leonardovazquez/IHP__QDLL6501/release/v.1.0.0/doc/UNIC-CASS_QDLL_Mock Tape Out.pdf

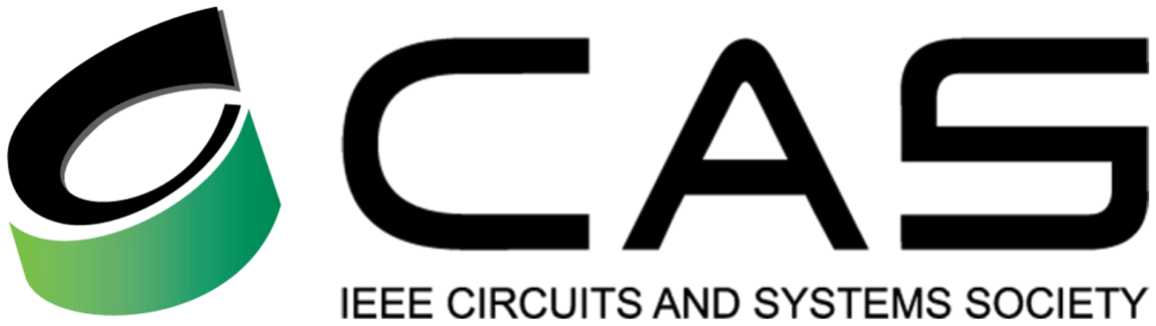
[picture p1: figure]

# UNIC-CASS

# Mock Tapeout “250 MHz Quadrature Delay Locked Loop ”

27.01.2026

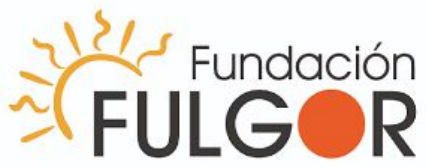
[picture p2: figure]
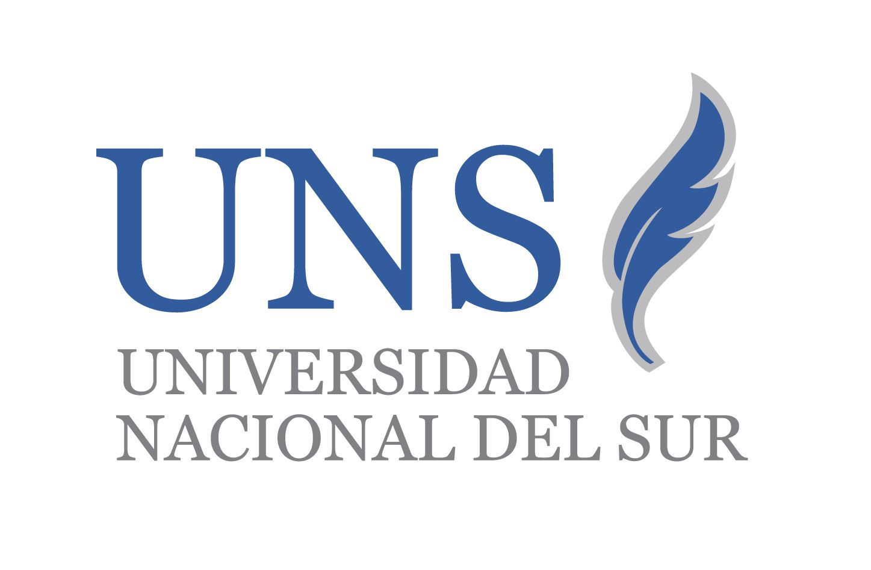
[picture p3: figure]
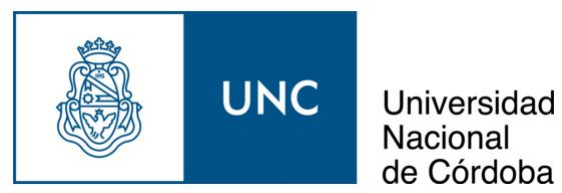
[picture p4: figure]

# Content

## 1. Fundamentals

## 2. QDLL Project: Block Diagram and Specifications

## 3. Schematics: TOP and Sub-blocks: Symbols & Schematics & Layouts

## 4. Characterization Testbenches

5. TOP Simulation: Testbench with the IO-Cells. Characterization Testbenches.
6. QDLL Layout: Top Layout and layout within the pad ring.
7. QDLL: Pins and IO Cells.

## 8. Project Status

# 1- QDLL Fundamentals

# 1 - QDLL Fundamentals

The Quadrature Delay Locked Loop (QDLL) is a phase control system designed to delay a differential CMOS input signal by 90°, generating a differential quadrature-phase output.

The QDLL operates through three key components:

1. Phase Detector (PD) + Charge Pump (CP):: Measures the phase difference between the input signal ϕin and the delayed output ϕout , and generates a proportional
voltage | Vcont.
2. Large Voltage-Controlled Delay Line (Large VCDL): Introduces a controllable delay to the input signal,
adjusted | by | the | control | voltage | Vcont.
3. Feedback Loop: Processes the phase error signal from the phase detector and adapts the VCDL delay until the
phase | difference | is | locked | at | 90°.

The main goal of the QDLL is to achieve and maintain a quadrature (90°) phase shift between the input and output signals.

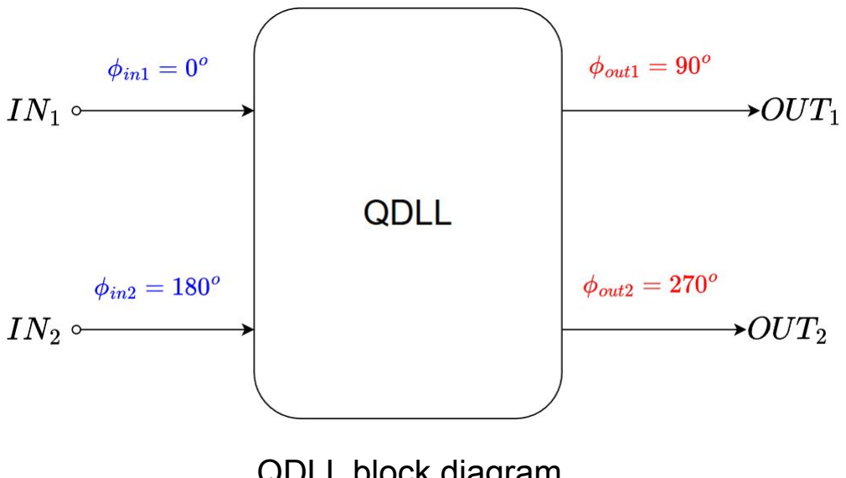
[picture p5: figure]

QDLL block diagram

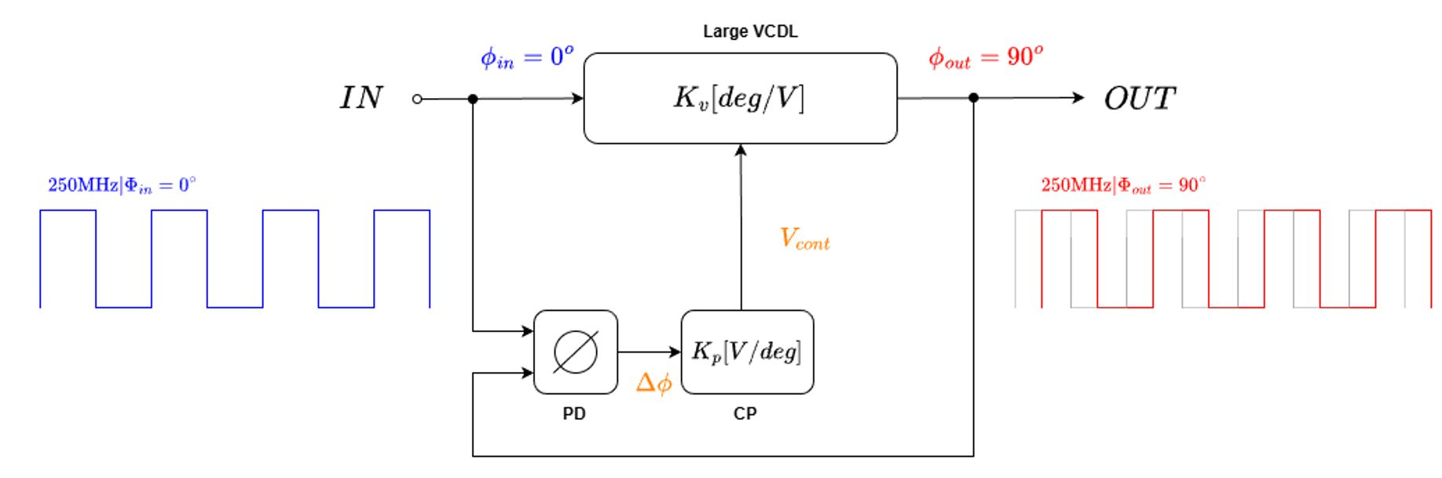
[picture p6: figure]

Single QDLL Operation

# 1 - QDLL Fundamentals

If we model the diagram of the single QDLL operation, we observe the phase detector compares the input and output phases (ϕin & ϕout), and any phase error is converted into a control voltage via the charge pump or loop filter. This voltage, Vcont , tunes the delay element (Large VCDL) with gain KvKp, adjusting the phase of the output signal ϕout.

On the other hand, using a single pole (1/S) in the feedback path guarantees inherent stability and ensures smooth convergence. Therefore, a simple RC network can be an effective choice for implementation.

This feedback mechanism ensures that the system locks the output phase at a fixed offset (e.g., 90° for QDLL) from the input phase eliminating steady-state phase error.

The Phase Converge plot shows that:

- A stable locking point exists where the two characteristics intersect. ( 90° is the desired )
- The negative slope of the VCDL ensures that the loop has a stable operating point.

QDLL System Operation

Phase Convergence

# 2- QDLL Project Diagram & Specifications

# 2 - QDLL Project Diagram

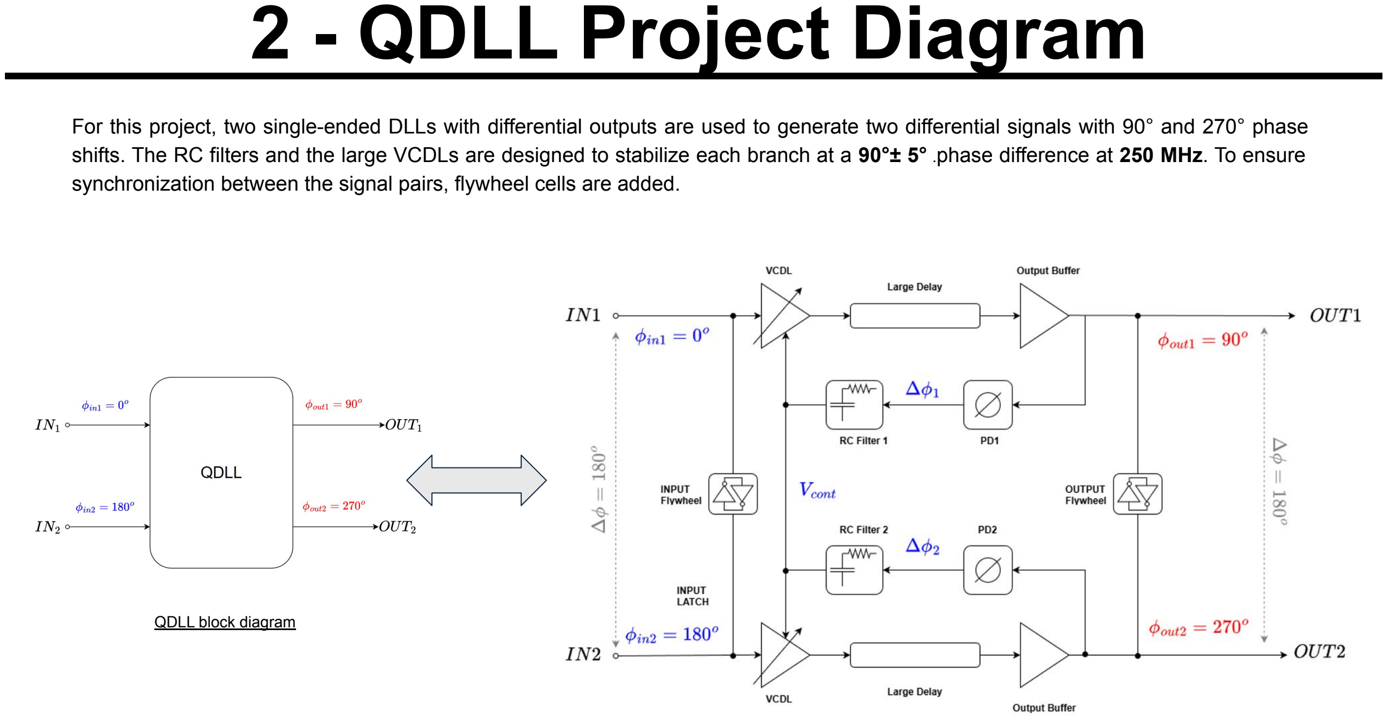
[picture p7: page 7]

For this project, two single-ended DLLs with differential outputs are used to generate two differential signals with 90° and 270° phase shifts. The RC filters and the large VCDLs are designed to stabilize each branch at a 90°± 5° .phase difference at 250 MHz. To ensure synchronization between the signal pairs, flywheel cells are added.

QDLL block diagram

# 2 - QDLL Project Specifications

The design specifications were modified due to the high-frequency behavior of the I/O cells. As a result, the performance requirements were relaxed, along with adjustments to the project focus and the number of input/output pins.

ihp 130 nm

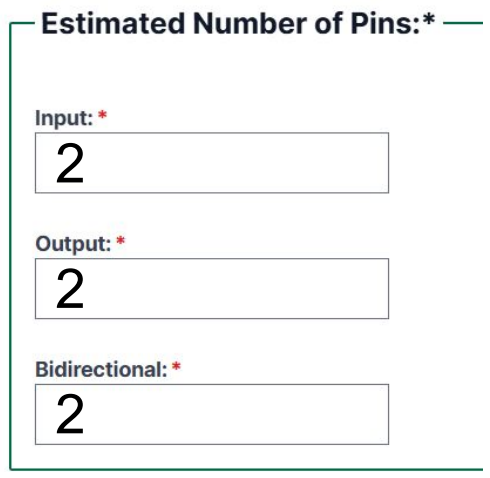
[picture p8: figure]

Pins:

- 2 Bi-direcctional: VDD, VSS
- 2 inputs: inpad1, inpad2
- 2 outputs: outpad1, outpad2

QDLL Specifications

Boundary Conditions | Requirement
Techn. | CMOS
Node | 130 nm
Supply Voltage | 1.2 ± 5% V
Temperature | [0, 65, 125] °C
Input Amplitude | [0 , 1.2 ] V (CMOS)
Input Frequency | 250±25 MHz
Input/Output Type | Fully Differential
Specifications | Value
Phase Difference | 90 ± 5 degrees
Output Swing | [0 , 1.2 ] V (CMOS)
t_rise/t_fall output | <
Vcont_ripple | ≥ 9 bits
Output Jitter | ≥ 7.5 bits

# 3- QDLL Project Schematics & Layouts

# 3 - QDLL Schematics (TOP)

# - Differential QDLL TOP:

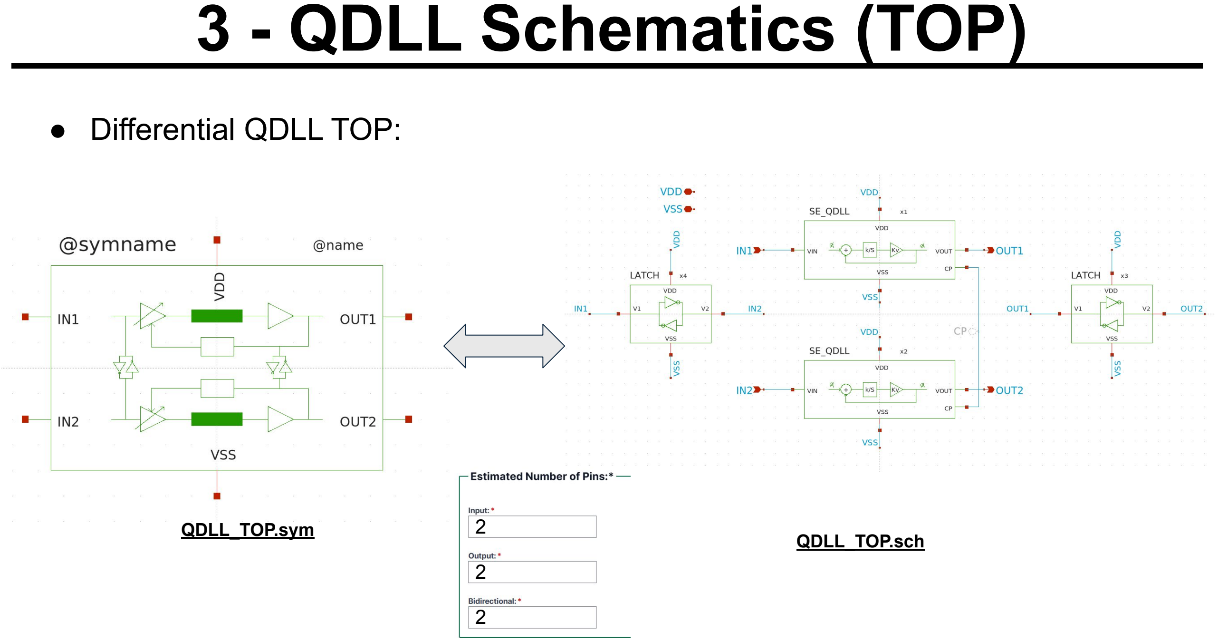
[picture p9: page 10]

2

2

2

QDLL_TOP.sym | QDLL_TOP.sch

# 3 - QDLL Schematics

# - Single-Ended QDLL:

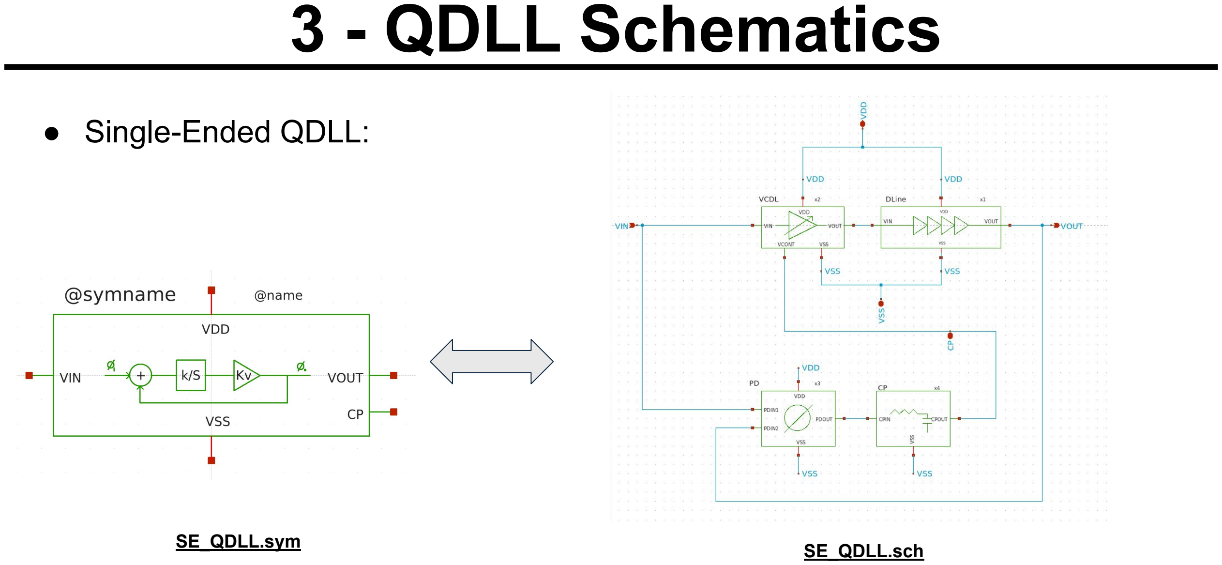
[picture p10: page 11]

SE_QDLL.sym | SE_QDLL.sch

# 3 - QDLL Schematics & Layouts

# - Voltage-Controlled Delay Line (VCDL) :

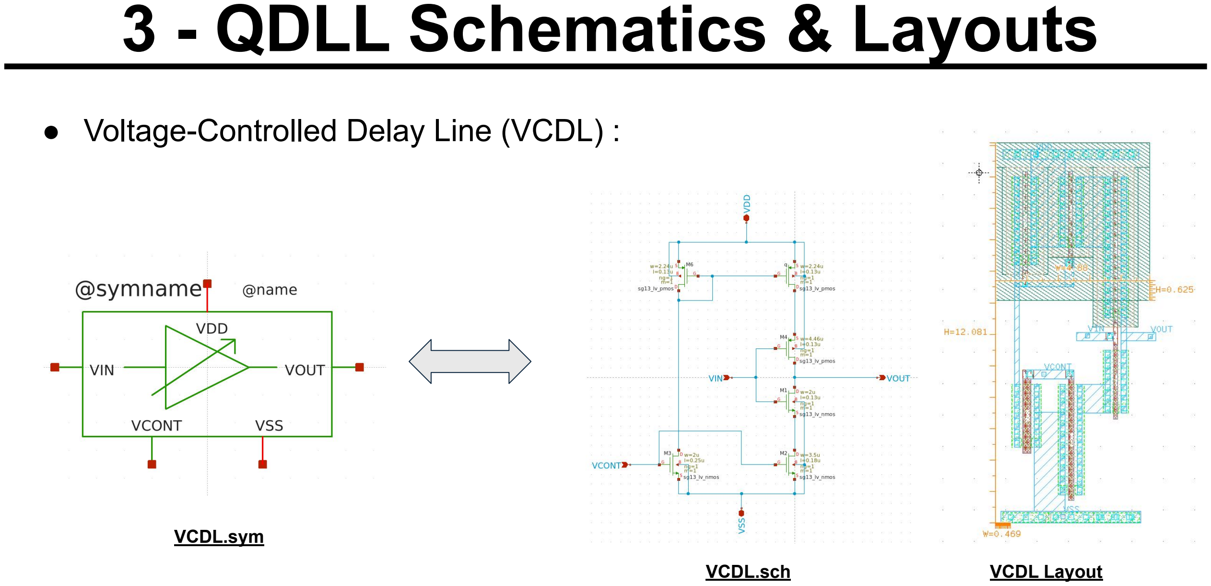
[picture p11: page 12]

VCDL.sym

VCDL.sch | VCDL Layout

# 3 - QDLL Schematics & Layouts

# - Large delay Line + Buffer Stage (DLine) :

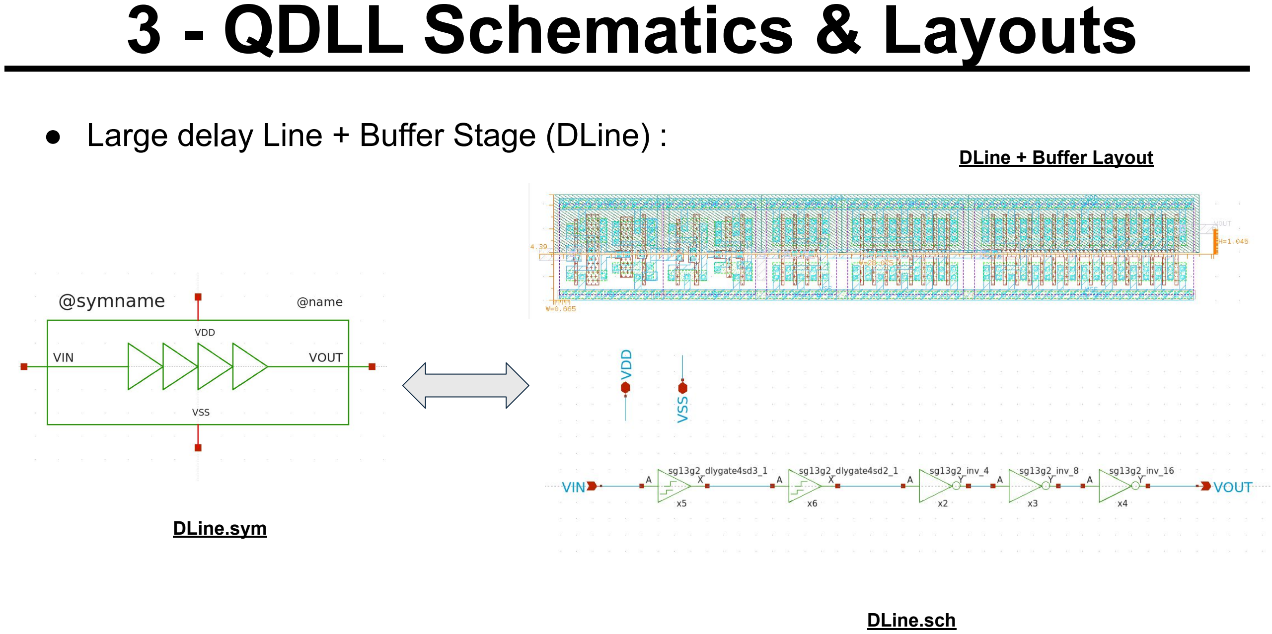
[picture p12: page 13]

DLine.sym

DLine.sch

DLine + Buffer Layout

# 3 - QDLL Schematics & Layouts

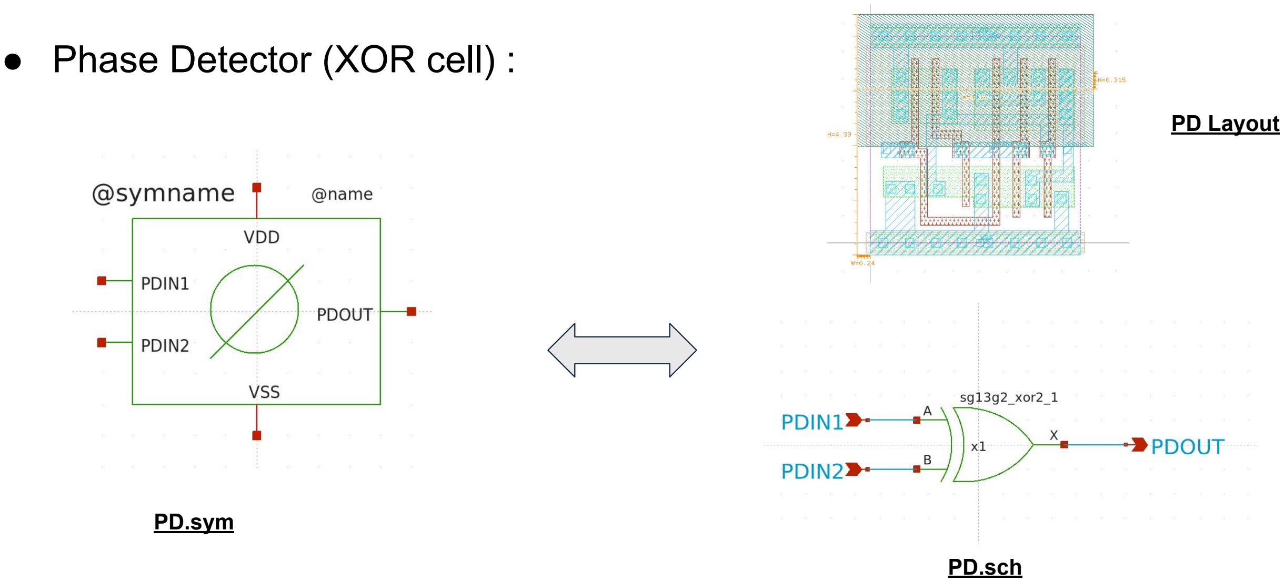
[picture p13: figure]
● Phase Detector (XOR cell) :; PD.sym; PD.sch; PD Layout

# 3 - QDLL Schematics & Layouts

# - Charge-Pump/ RC Loop Filter:

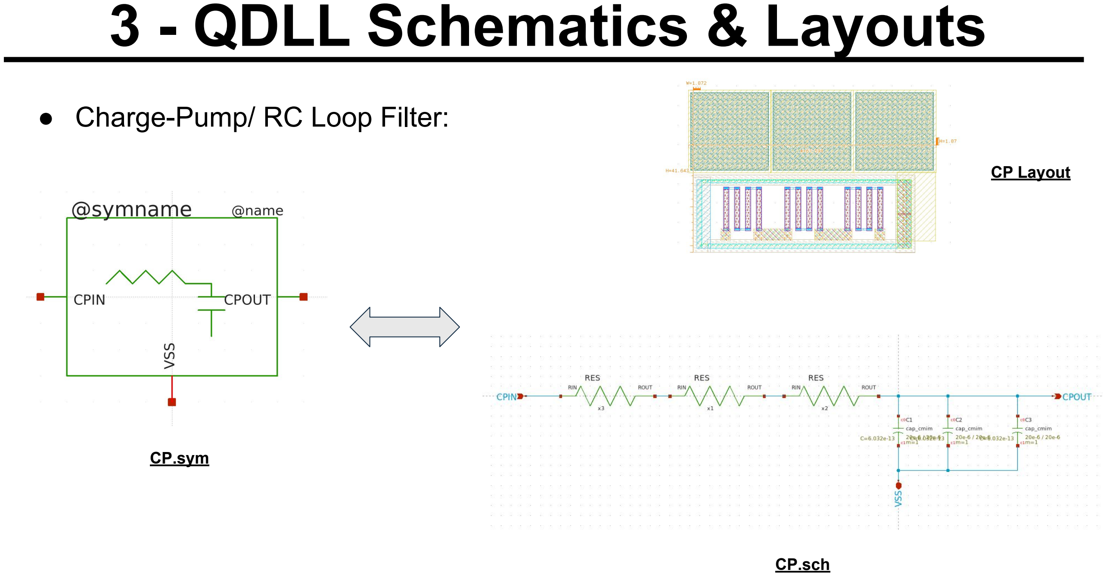
[picture p14: page 15]

CP.sym

CP.sch

CP Layout

# 3 - QDLL Schematics & Layouts

# - Series Resistors:

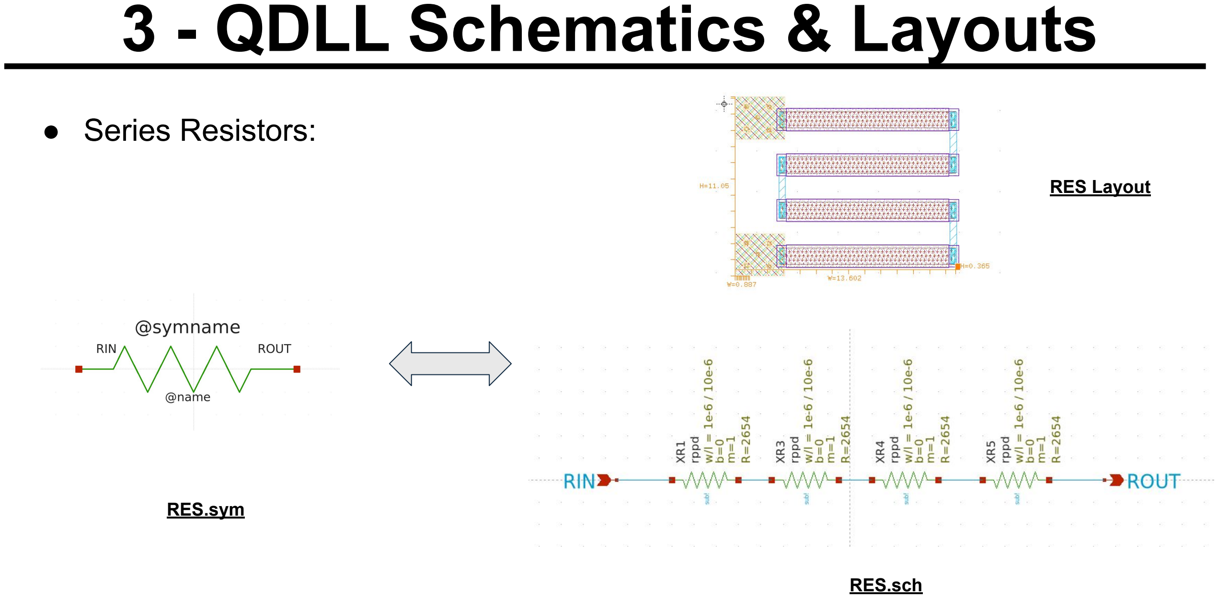
[picture p15: page 16]

RES.sym

RES.sch

RES Layout

# 3 - QDLL Schematics

# - Flywheel Latchs:

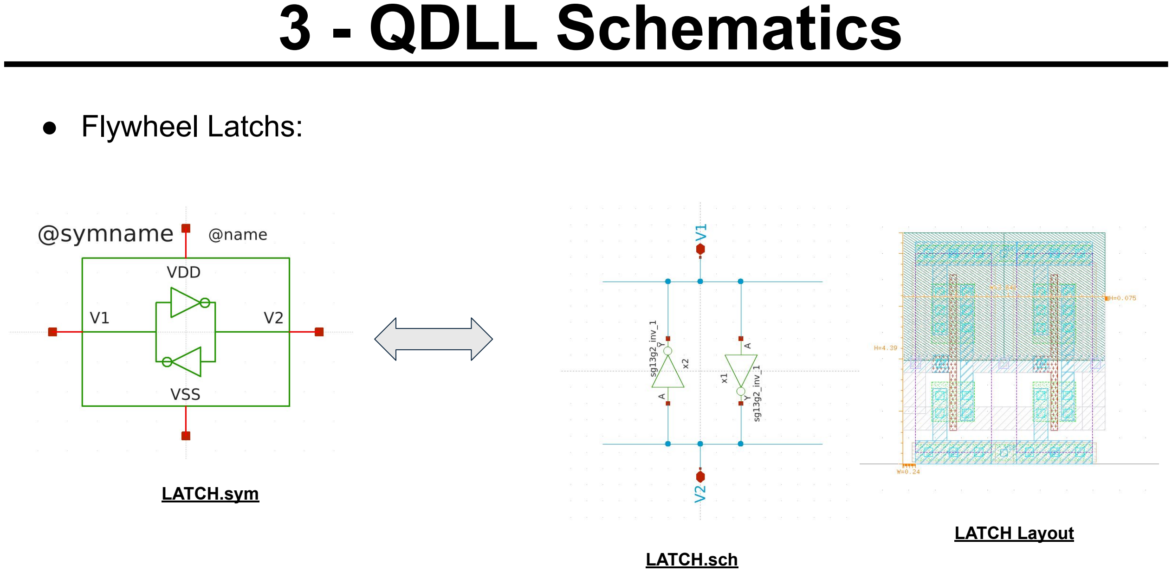
[picture p16: page 17]

LATCH.sym

LATCH.sch

LATCH Layout

# 4- QDLL Characterization Testbenchs

# 4 - QDLL Testbenchs

# - PD + CP Characterization Testbench

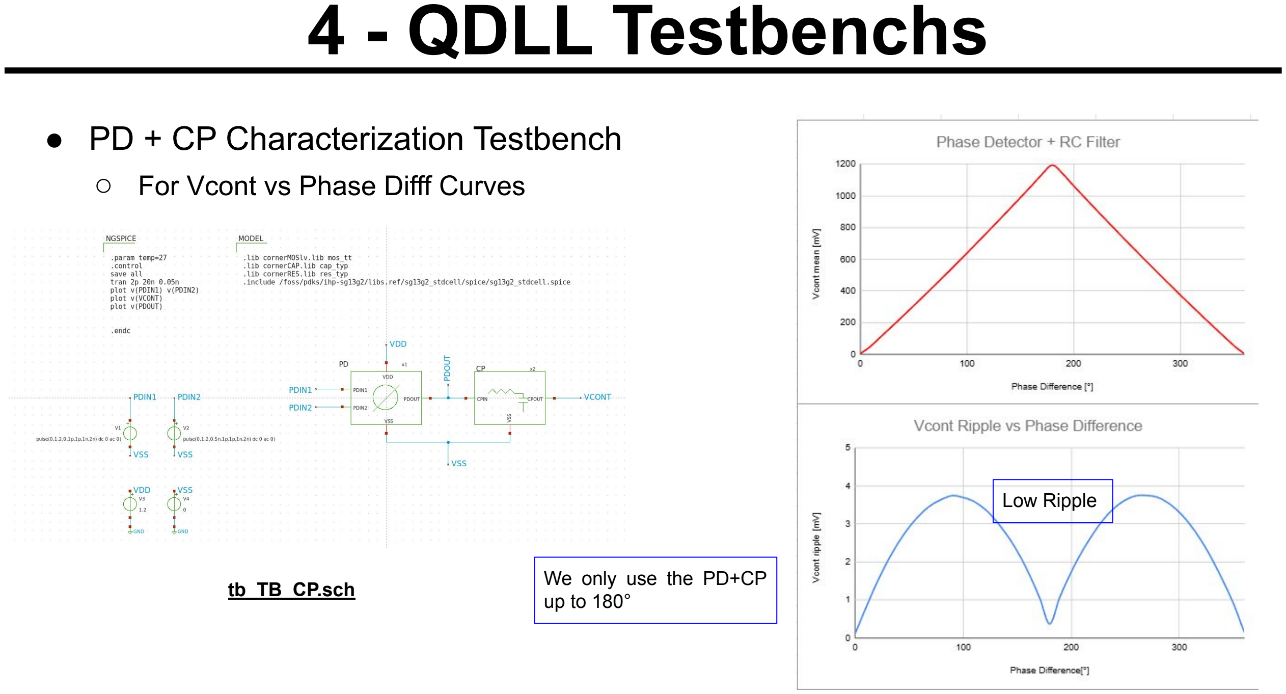
[picture p17: page 19]

## - For Vcont vs Phase Difff Curves

tb_TB_CP.sch

Low Ripple

We only use the PD+CP
up to 180°

# 4 - QDLL Testbenchs

# - IO CELLS Characterization Testbench

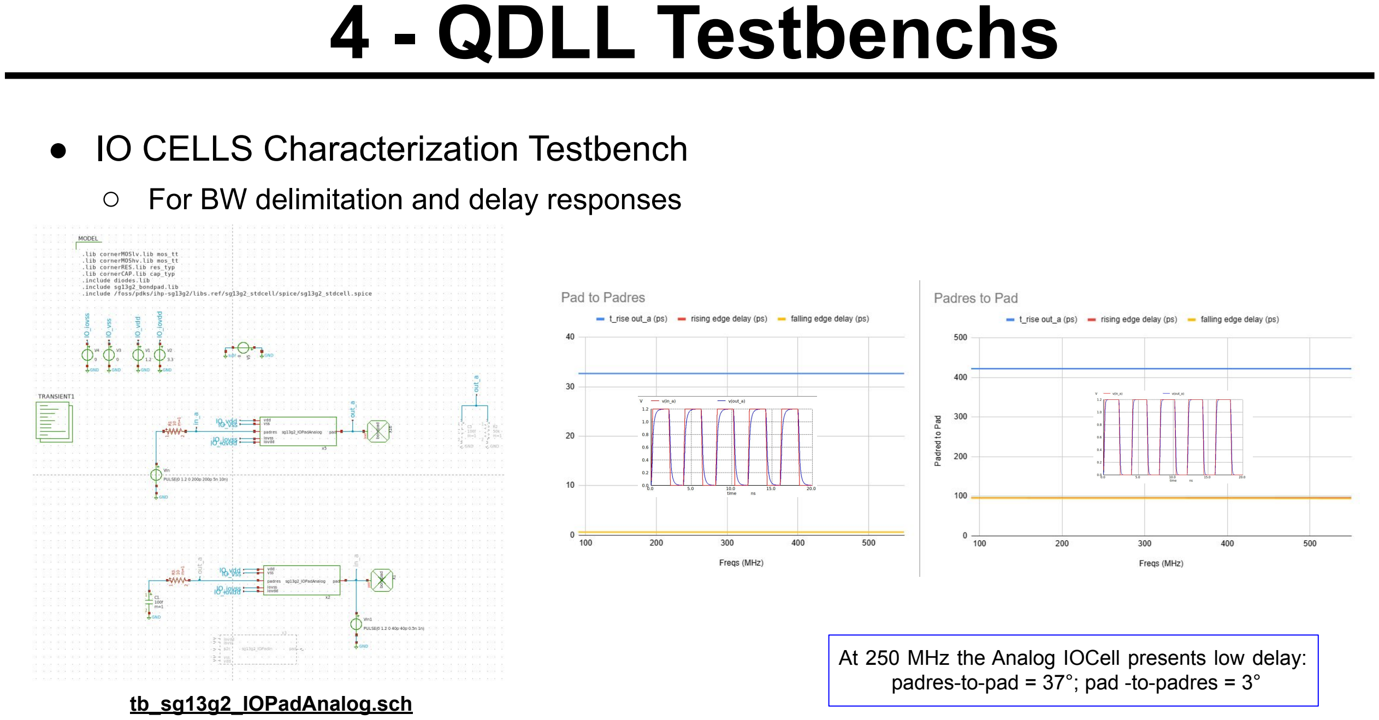
[picture p18: page 20]

## - For BW delimitation and delay responses

tb_sg13g2_IOPadAnalog.sch

At 250 MHz the Analog IOCell presents low delay: padres-to-pad = 37°; pad -to-padres = 3°

# 4 - QDLL Testbenchs

# - Open Loop for Large Delay Line Characterization Testbench

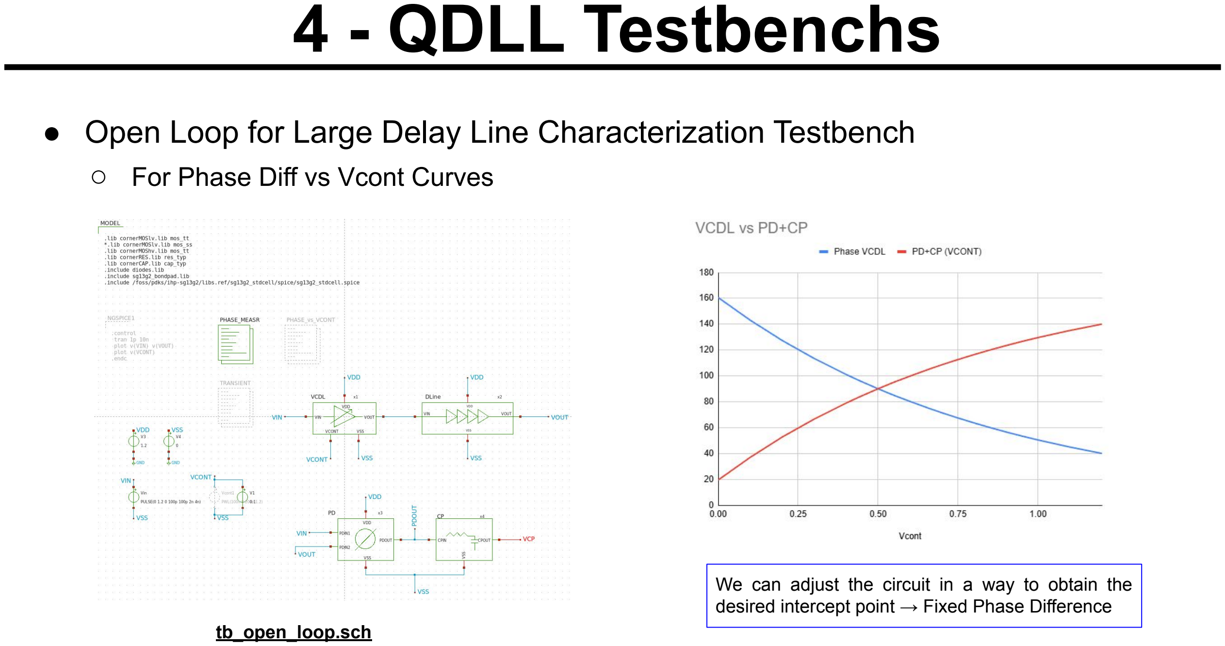
[picture p19: page 21]

## - For Phase Diff vs Vcont Curves

tb_open_loop.sch

We can adjust the circuit in a way to obtain the desired intercept point → Fixed Phase Difference

# 5- QDLL TOP Testbench

# 5 - QDLL TOP Testbench (TT)

# - TOP Testbench with the IOCELLS

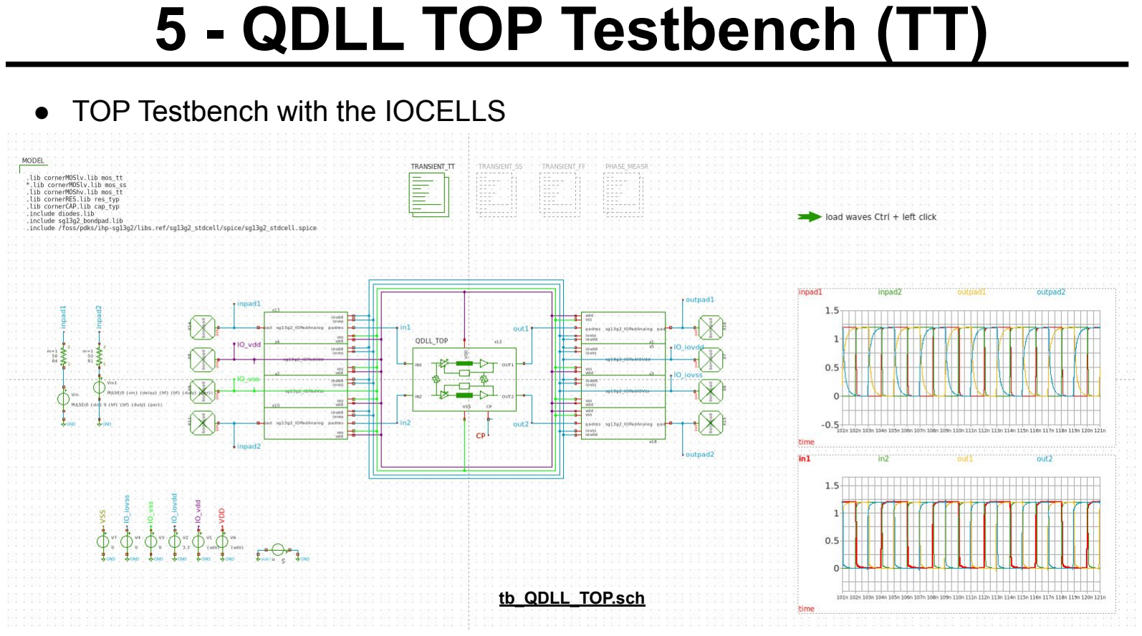
[picture p20: page 23]

tb_QDLL_TOP.sch

# 5 - QDLL TOP Testbench (TT)

# - Setup Time

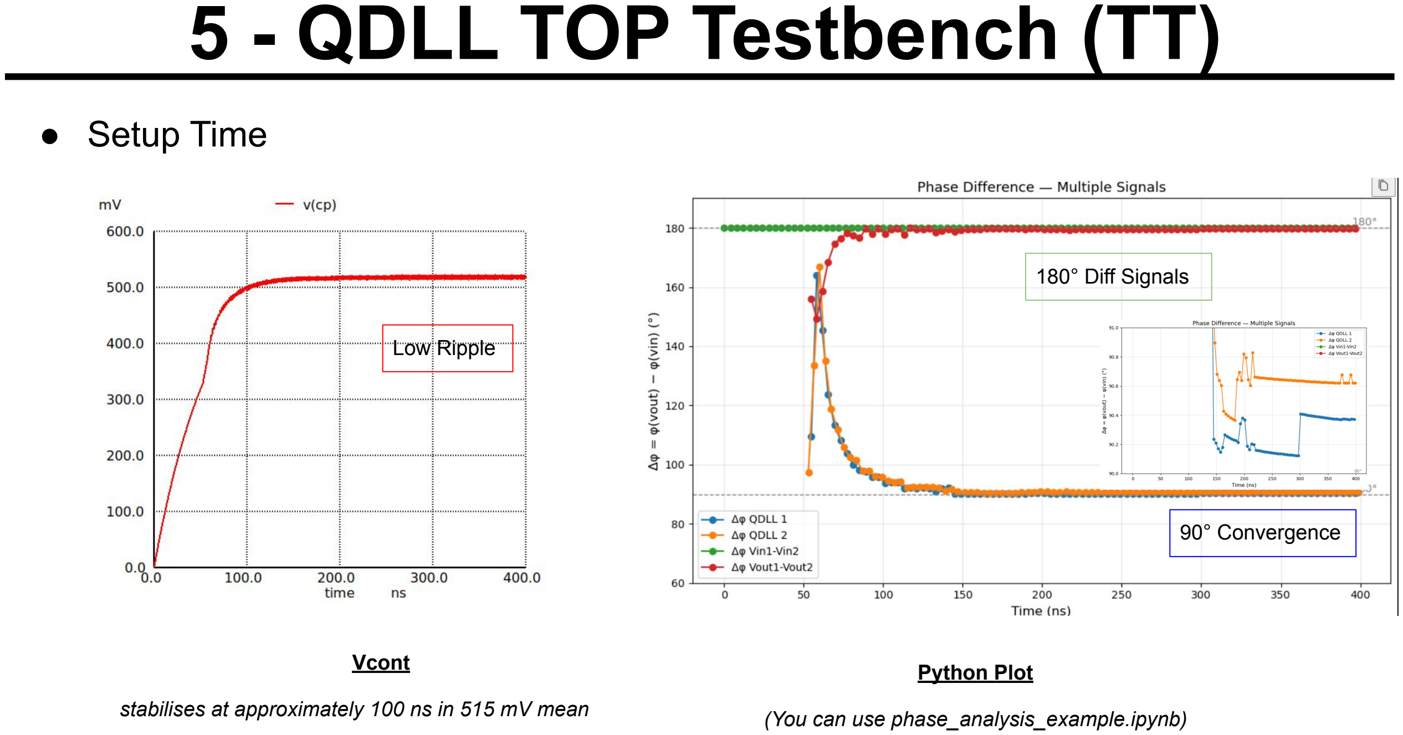
[picture p21: page 24]

Python Plot

(You can use phase_analysis_example.ipynb)

90° Convergence

180° Diff Signals

Vcont

stabilises at approximately 100 ns in 515 mV mean

Low Ripple

# 5 - QDLL TOP Testbench (TT)

# - Input/Output Signals

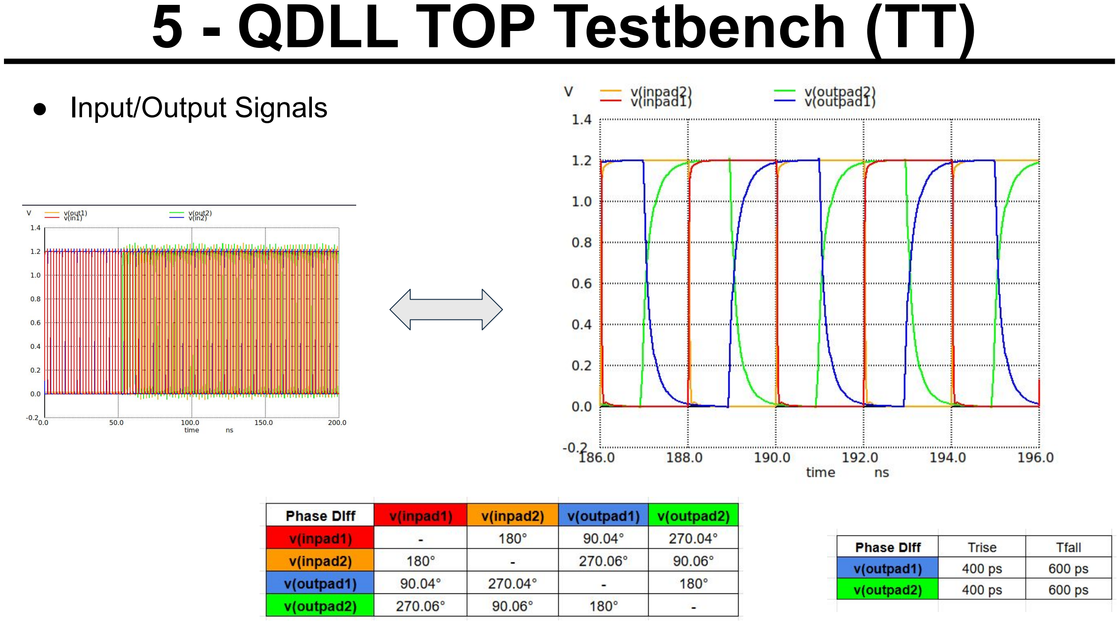
[picture p22: page 25]

# 5- QDLL Layout TOP

# QDLL Top Layout Placement

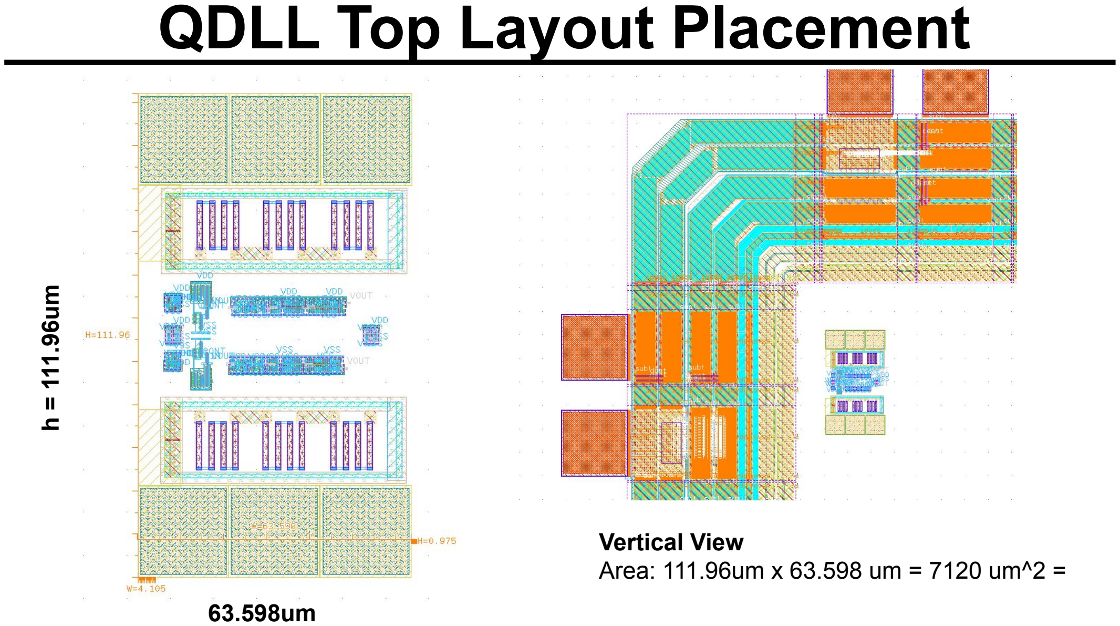
[picture p23: page 27]

## h = 111.96um

63.598um

## Vertical View Area: 111.96um x 63.598 um = 7120 um^2 =

# QDLL Top Layout Placement v1

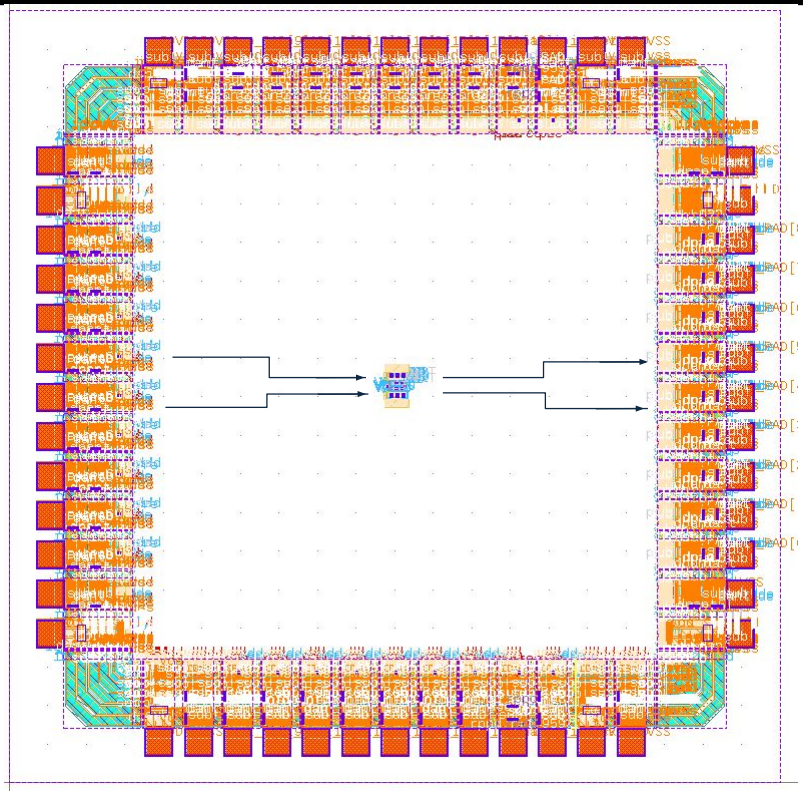
[picture p24: figure]

## One possible goal would be to place the QDLL vertically and connect the inputs on the left and the outputs on the right with high metal top

routing.

For | a | 250 MHz | signal,

## standard IO cells have been tested and found to perform

well. However, if available,

## we prefer to interface with 50 Ω systems using IO cells

with matched impedance.

# QDLL layout within the pad ring

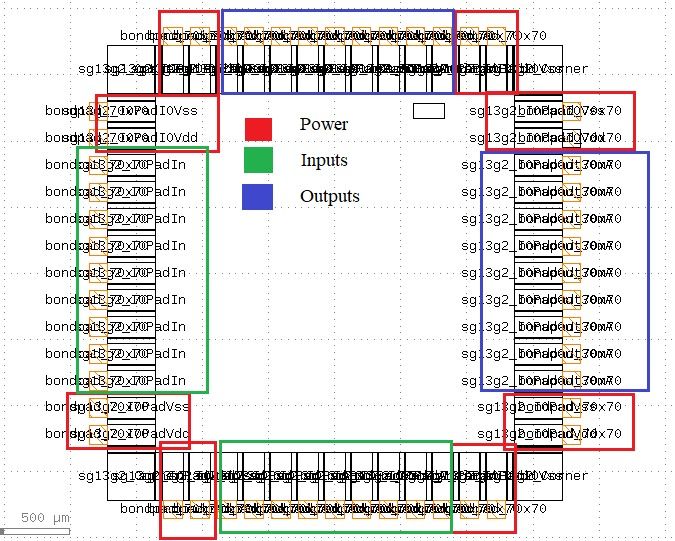
[picture p25: figure]

# 7 - QDLL Pins and IO CELLS

# Pins and IO Cells

## QDLL Pins

## N° Pins: 4 - 2 Input Pins - 2 Output Pin - 2 Power Supply Pins (VDD , VSS)

Pin Type | Name | IOCELL
Input | inpad1 | sg13g2_IOPADAnalog
Input | inpad2 | sg13g2_IOPADAnalog
Output | outpad1 | sg13g2_IOPADAnalog
Output | outpad1 | sg13g2_IOPADAnalog

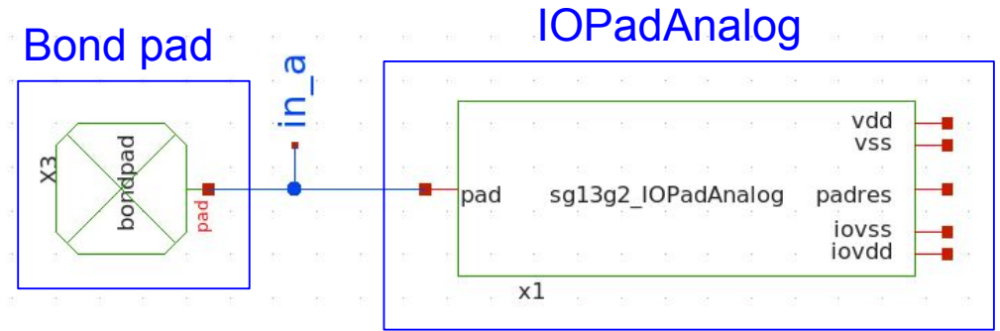
[picture p26: figure]
Bond pad; IOPadAnalog

Power Supply | VDD | sg13g2_IOPadVdd
Power Supply | VSS | sg13g2_IOPadVss

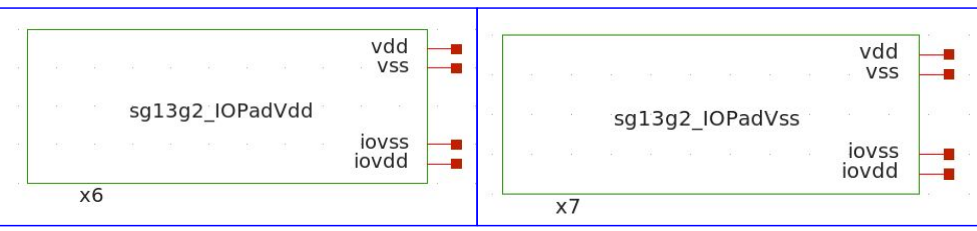
[picture p27: figure]

## Power Supply IOPads

# 8- QDLL Project Status

33

# Project Status

TOP | Sub-top | Sub-Block | Symbols & Schematic s | Testbench | Prelayout results | IOCELLS results (TT) | IOCELLS results (SS-FF) | Layout (DRC + LVS) | Postlayout results
QDLL TOP | - | - | Done | Done | Done | Done | To do | WIP | To do
- | SE_QDLL | - | Done | Done | Done | Done | To do | WIP | To do
- | - | VCDL | Done | Done | Done | Done | W/P | WIP | To do
- | - | DLine | Done | Done | Done | Done | WIP | Done | To do
- | - | CP | Done | Done | Done | Done | WIP | WIP | To do
- | - | PD | Done | Done | Done | Done | WIP | Done | To do
- | LATCH | - | Done | Done | Done | Done | WIP | Done | To do

## Project Status by Block:

## We are currently working on

the | DRC | (minimum | and
maximum) | verification | of

## several cells to achieve the

desired | LVS | verification.

## Next, we plan to compare the extracted views using Magic in order to obtain more

realistic results.

On | the | other | hand,
multi-corner | simulation

## results are desirable for our project, and we are actively

working toward that goal.
