leonardovazquez/IHP__QDLL6501/release/v.1.0.0/doc/DLL_top_full.png

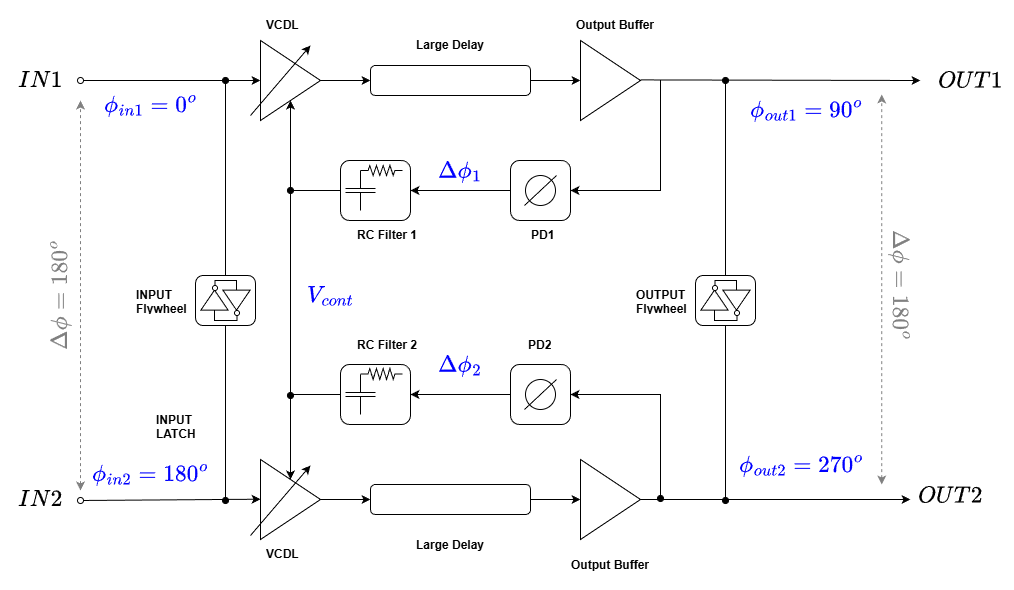
release/v.1.0.0/doc/DLL_top_full.png
