leonardovazquez/IHP__QDLL6501/release/v.1.0.0/doc/QDLL_Diagram.png

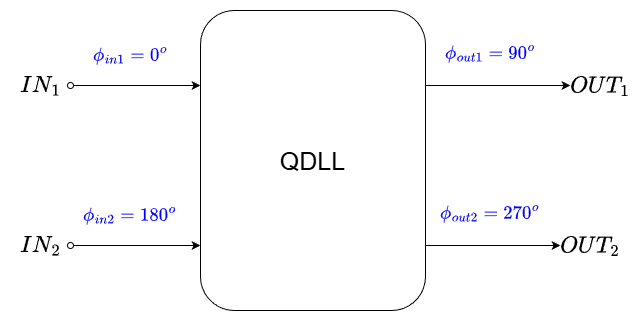
release/v.1.0.0/doc/QDLL_Diagram.png
