leonardovazquez/IHP__QDLL6501/release/v.1.0.0/doc/QDLL - VAZQUEZ - 2nd UNIC-CASS Progress Questionnaire.pdf

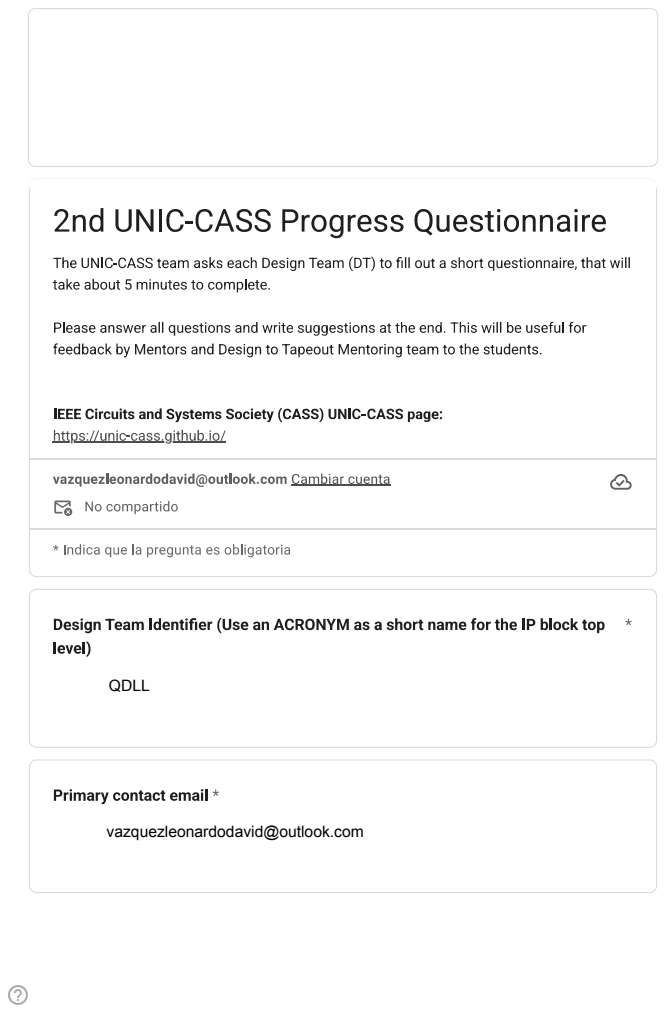
[picture p30: page 1]
QDLL

vazquezleonardodavid@outlook.com

## leonardo.vazquez@ieee.org

## Santiago Basignana

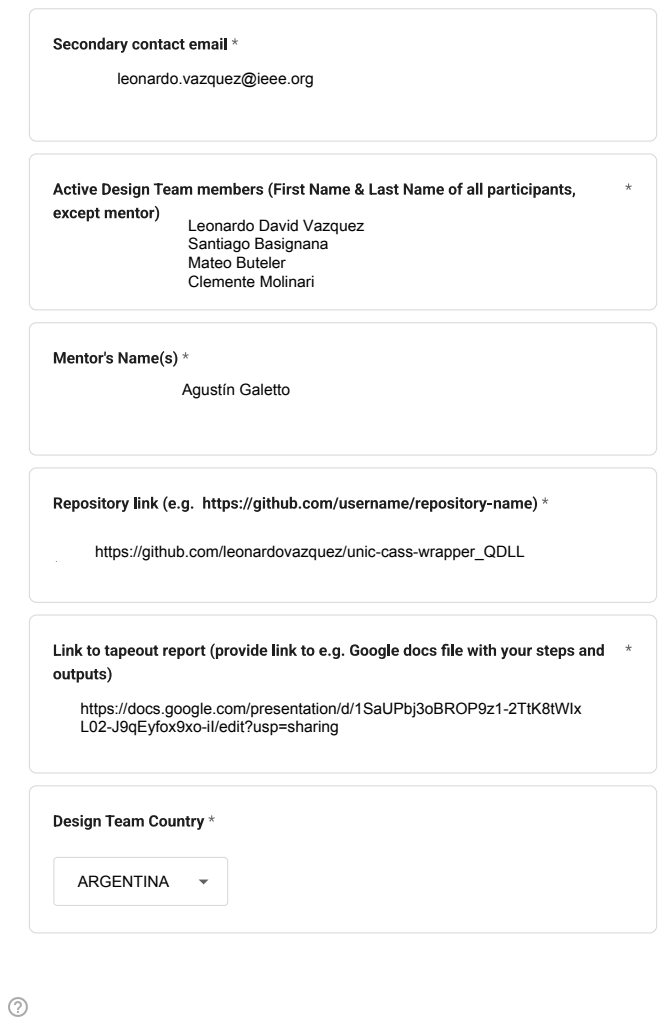
[picture p31: page 2]
Agustín Galetto; ARGENTINA

Leonardo David Vazquez
Mateo Buteler
Clemente Molinari

https://github.com/leonardovazquez/unic-cass-wrapper_QDLL

https://docs.google.com/presentation/d/1SaUPbj3oBROP9z1-2TtK8tWIx
L02-J9qEyfox9xo-iI/edit?usp=sharing

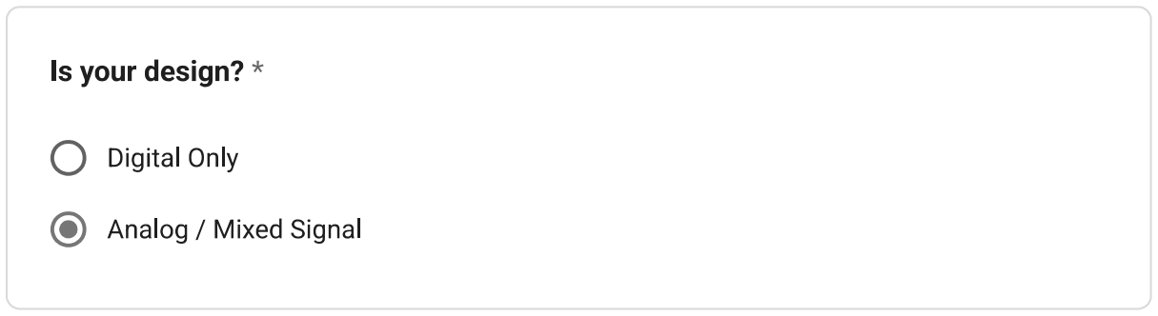
[picture p32: figure]

## sg13g2_IOPADAnalog that we mentioned in our document. Also, we can migrate

## models. If this is not possible, as we have demonstrated, we will use the IO Cells

## using IO cells with matched impedance. We would need the new RF iocells

## perform well. However, if available, we prefer to interface with RF 50•Ω systems

## V) 250•MHz input signal, standard IO cells have been tested and found to

## signal (2 inputs) and 1 differential output signal (2 outputs). For a CMOS (0-1.2

## The QDLL project basically consist on a single block with 1 differential input

## our project to a lower frequency, there is no problem. Thanks!

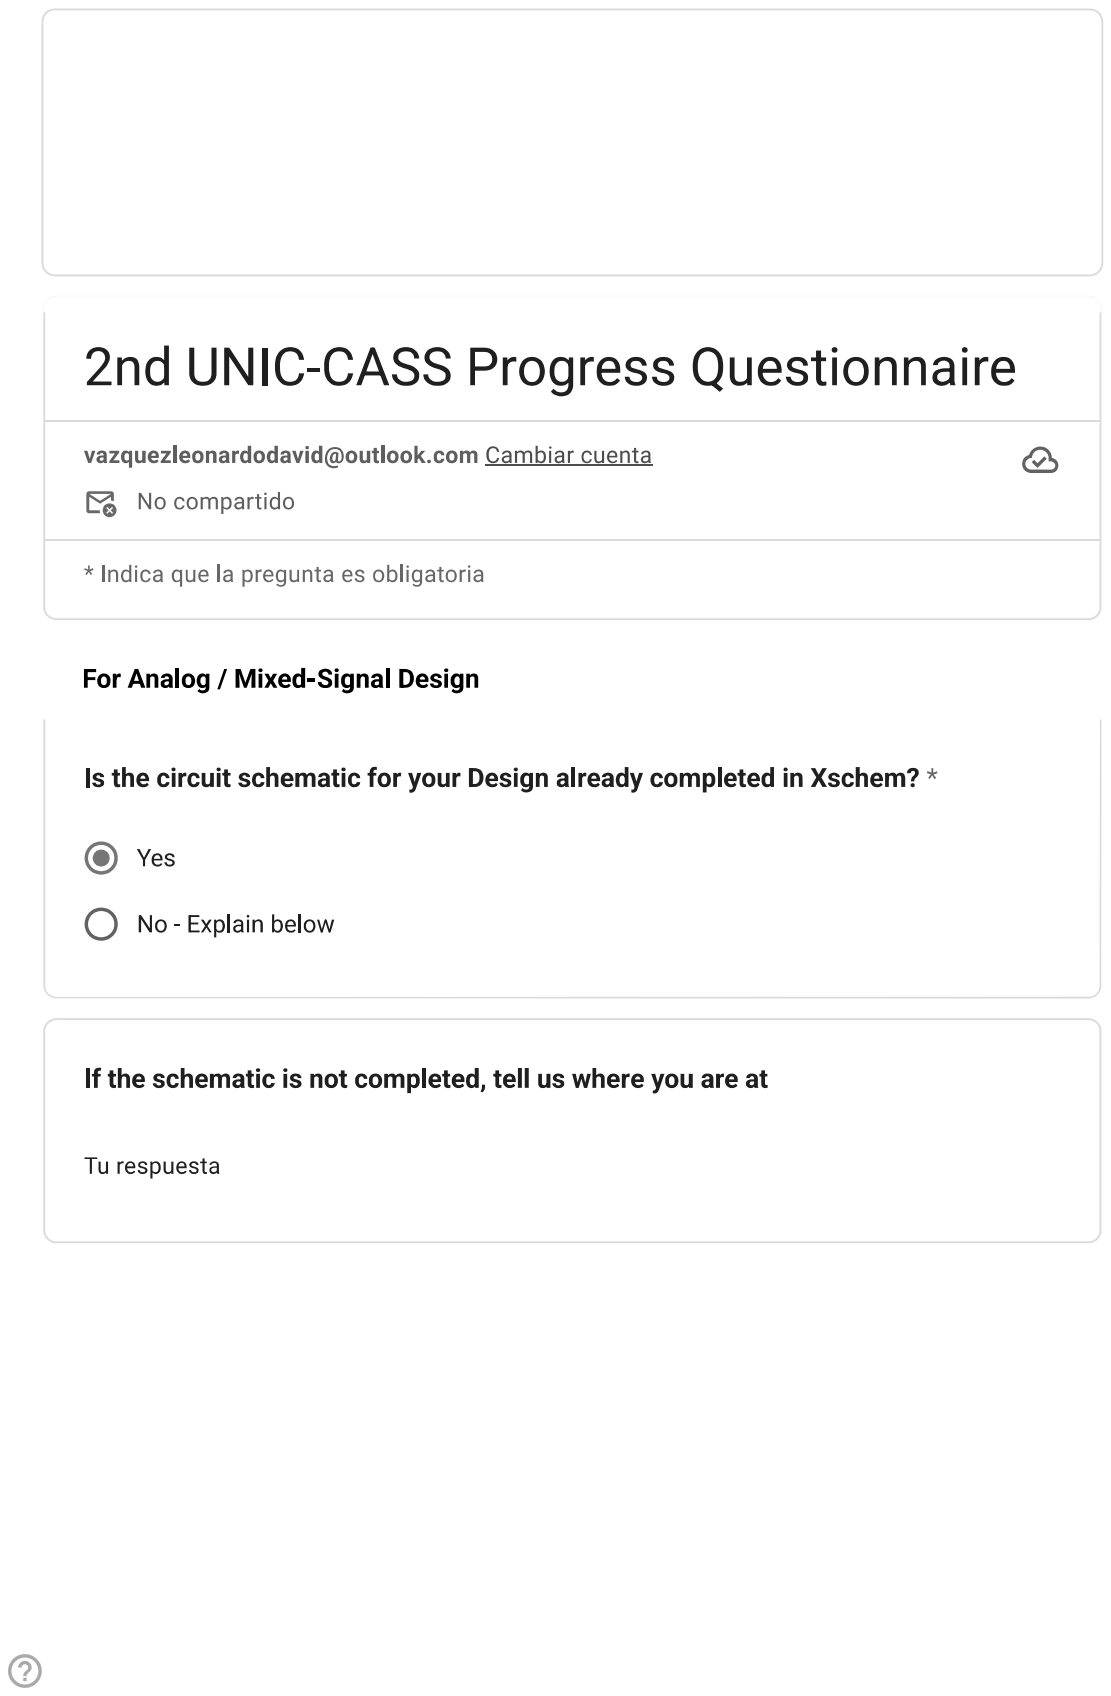
[picture p33: page 4]

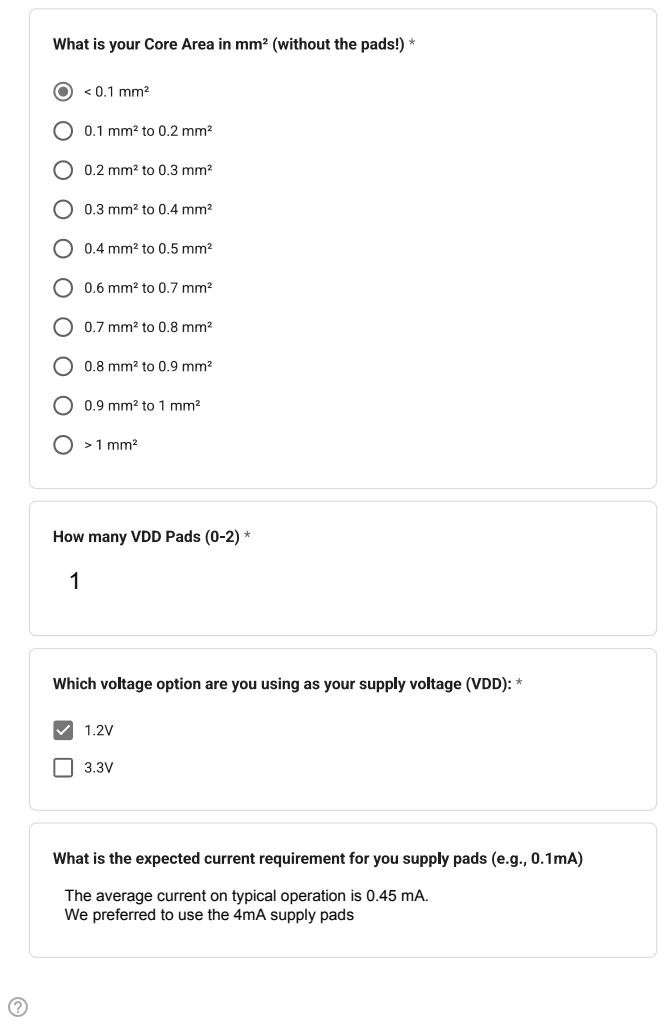
[picture p34: page 5]

The average current on typical operation is 0.45 mA.
We preferred to use the 4mA supply pads

1114

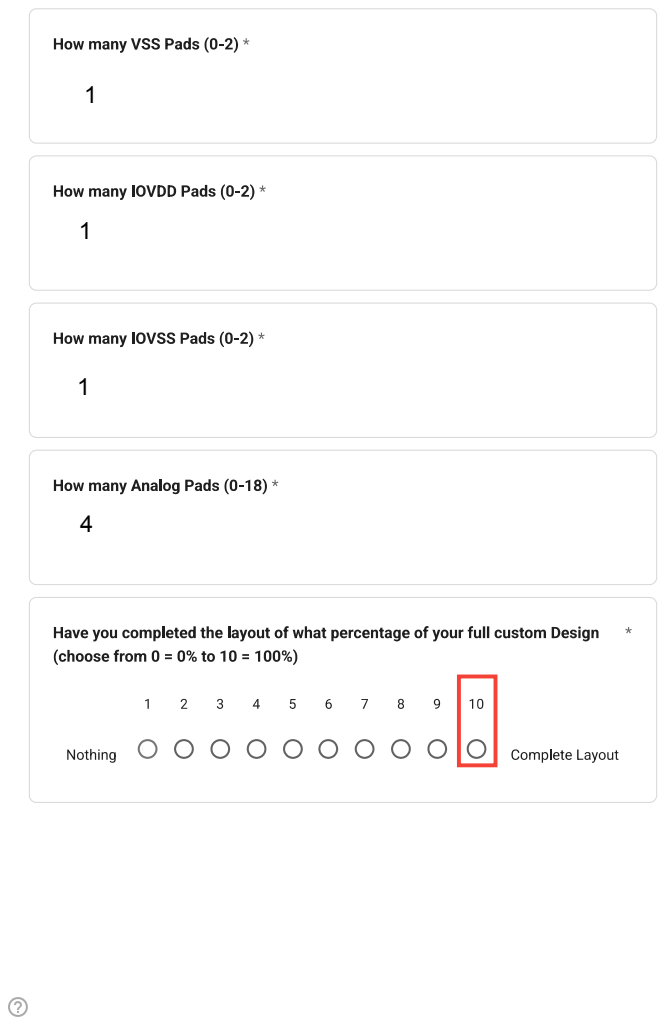
[picture p35: page 6]

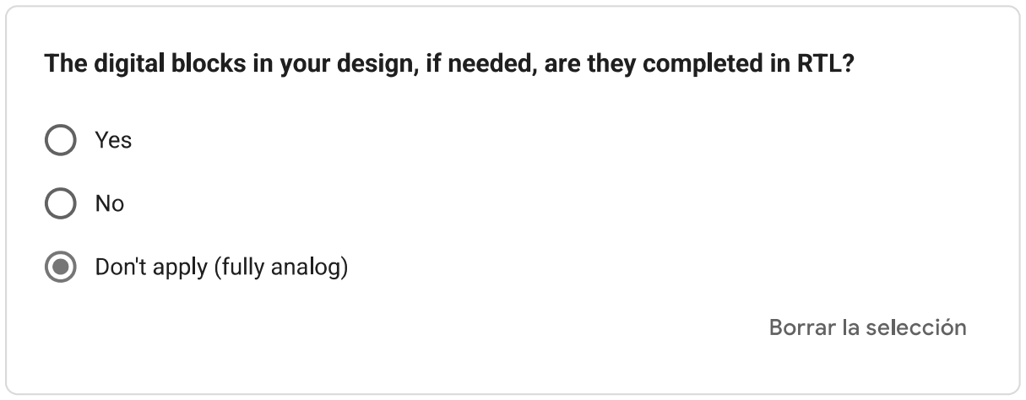
[picture p36: figure]
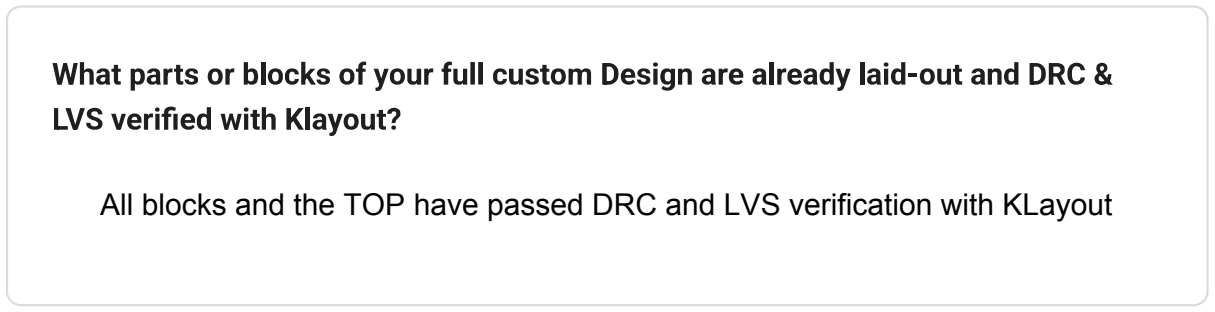
[picture p37: figure]

## All blocks and the TOP have passed DRC and LVS verification with KLayout

familiarized with the design flow, supported by the fact that two team members completed an year of experience using analog open-source EDA tools. Nevertheless, we have become well

Most members of the design team are graduate and undergraduate students with less than one

open-source analog design course taught by Prof. Jorge Marín within the UNICCAS program, which has been very beneficial for transferring knowledge to the rest of the team.

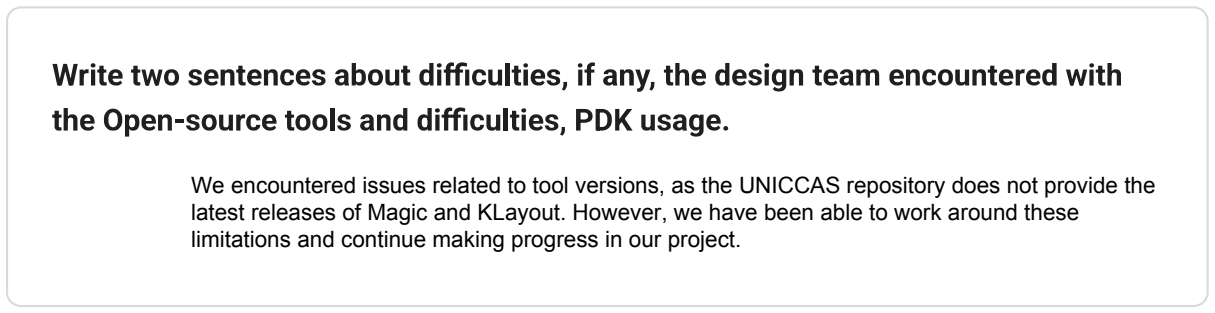
[picture p38: figure]

We encountered issues related to tool versions, as the UNICCAS repository does not provide the latest releases of Magic and KLayout. However, we have been able to work around these limitations and continue making progress in our project.
