leonardovazquez/IHP__QDLL6501/(commit log)

2026-03-25 Update README with project details and acknowledgements
    Expanded project documentation with team details, project goals, specifications, and current status.
2026-03-27 Project uploaded
    [CP.sch, DLYGATES2.sch, DLine.sch, INV16.sch, INV4.sch, LATCH.sch, PD.sch, QDLL.sch]
2026-03-28 Symbol Updates
    [CP.sch, DLYGATES2.sch, DLine.sch, INV16.sch, INV4.sch, LATCH.sch, PD.sch, QDLL.sch]
2026-04-13 schematic updates
    [CP.sch, DLine.sch, PD.sch, QDLL_TOP.sch, RES.sch, VCDL.sch]
2026-04-13 MPC schematic and symbol updates
    [MPC0349.sch, user_project_wrapper.sch]
2026-04-15 symbol paths updates
    [CP.sch, QDLL_TOP.sch]
2026-04-15 TOP pins updates
    [MPC0349.sch]
